inteliclinic/NeuroonOpenHardwareDocumentation/NeuroOn_Assembly.PDF

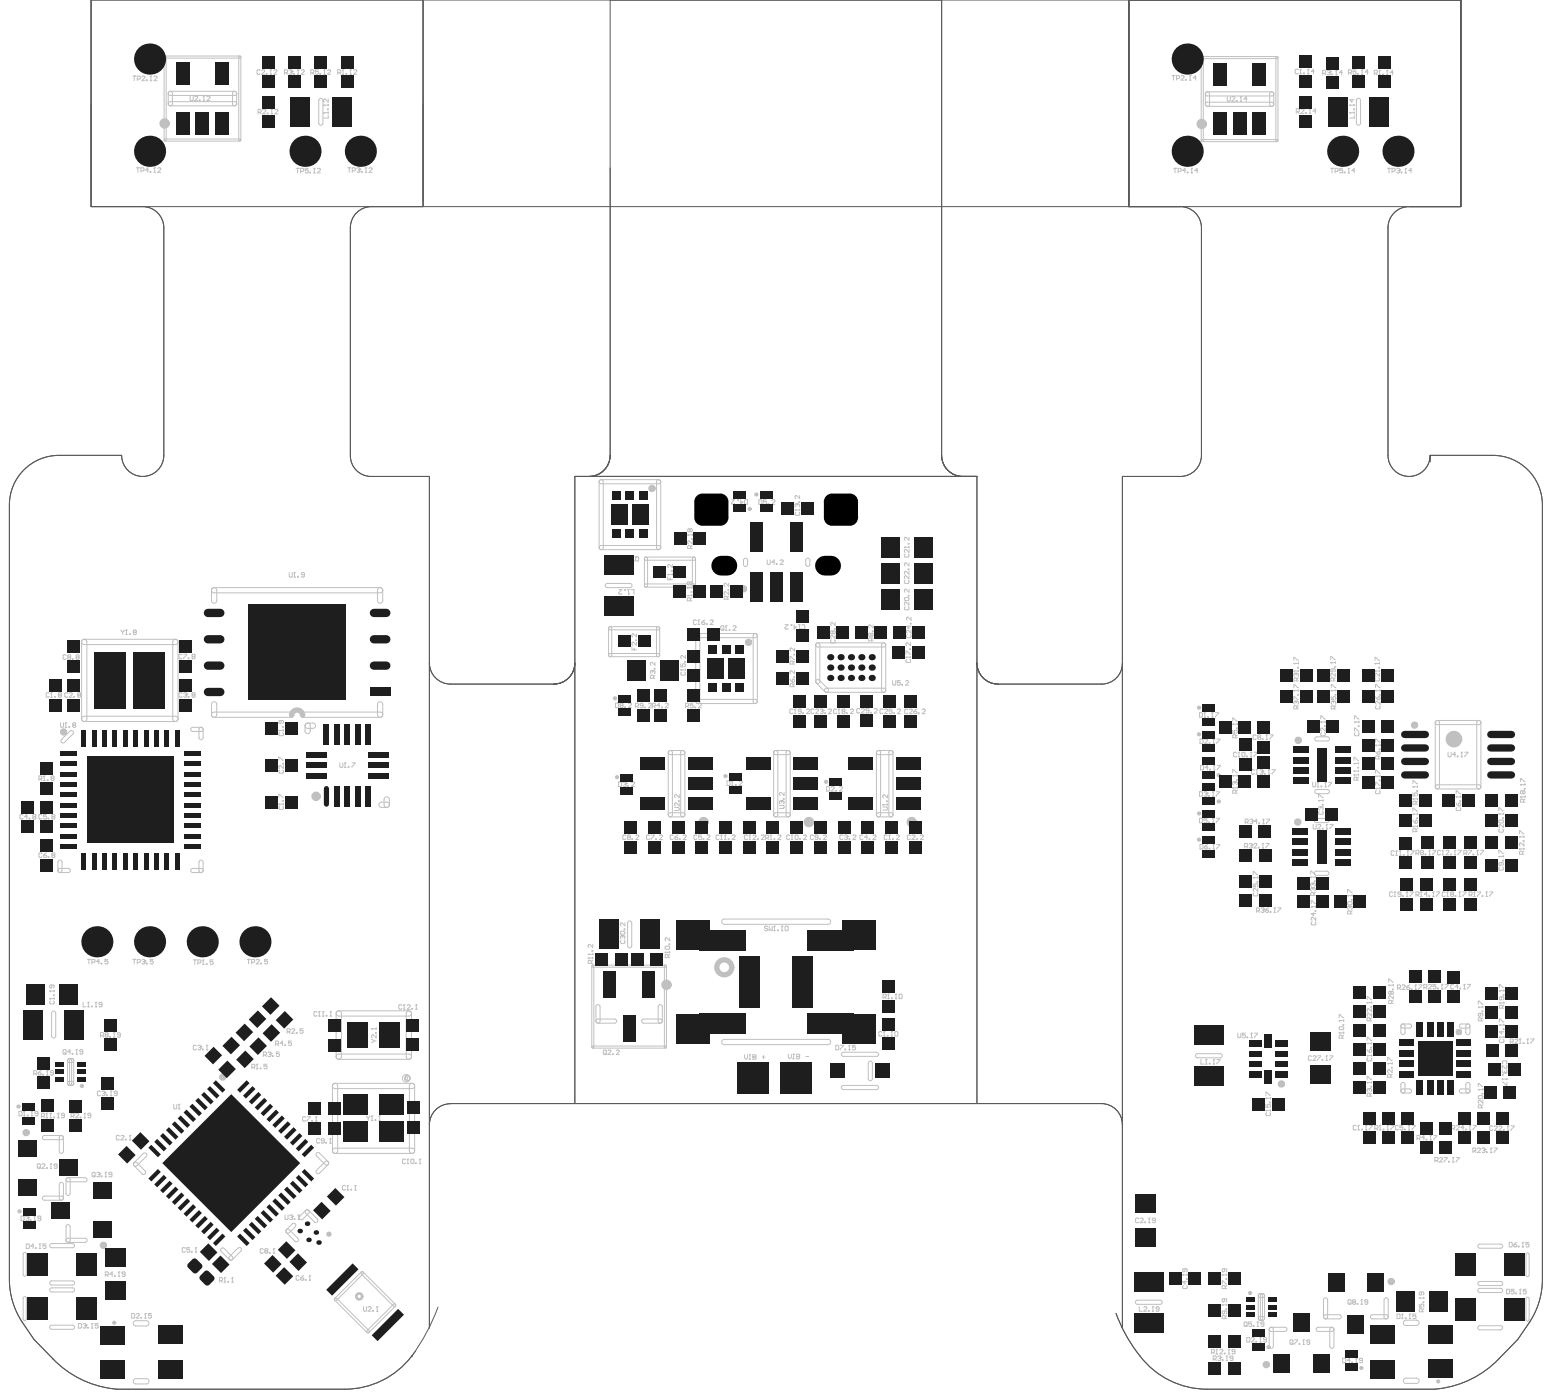
[picture p1: page 1]

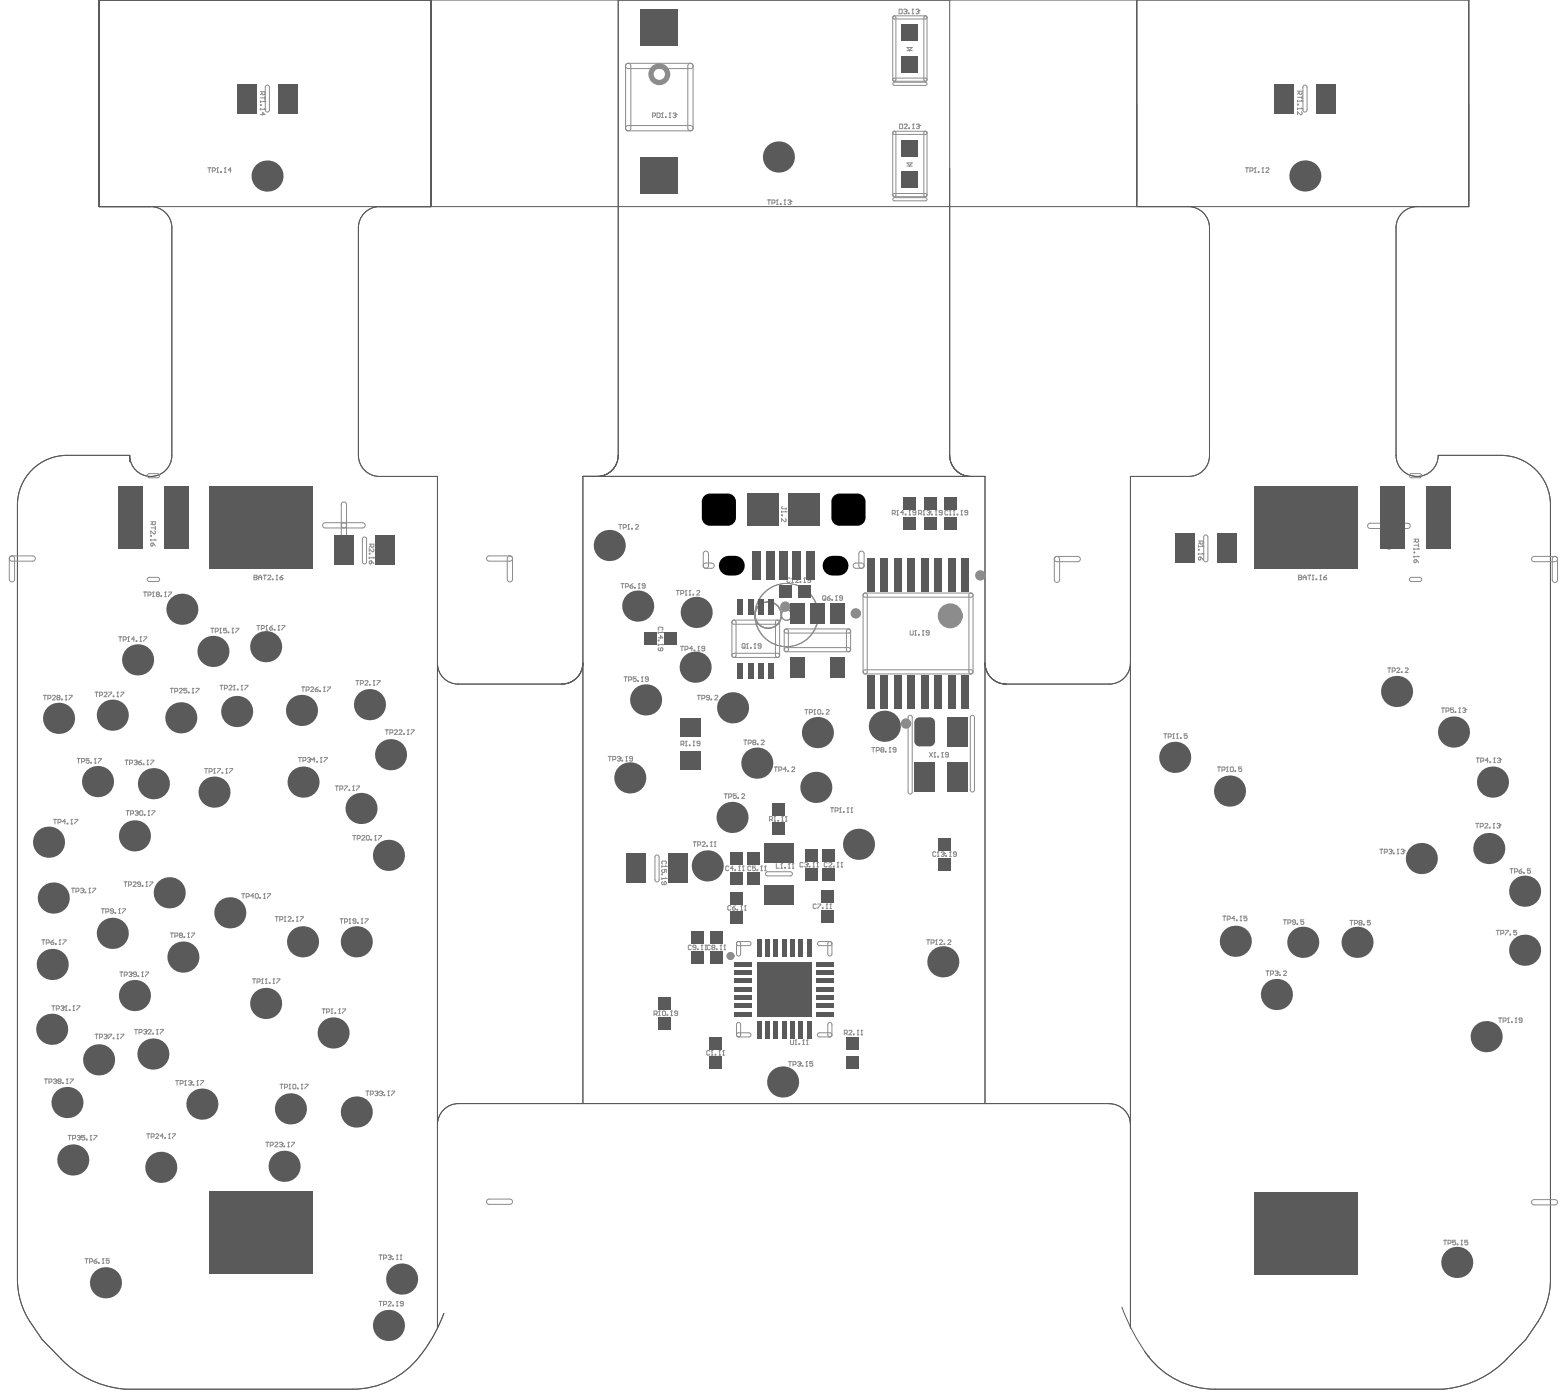
[picture p2: page 2]
