inteliclinic/NeuroonOpenHardwareDocumentation/NeuroOnMainBoard.pdf

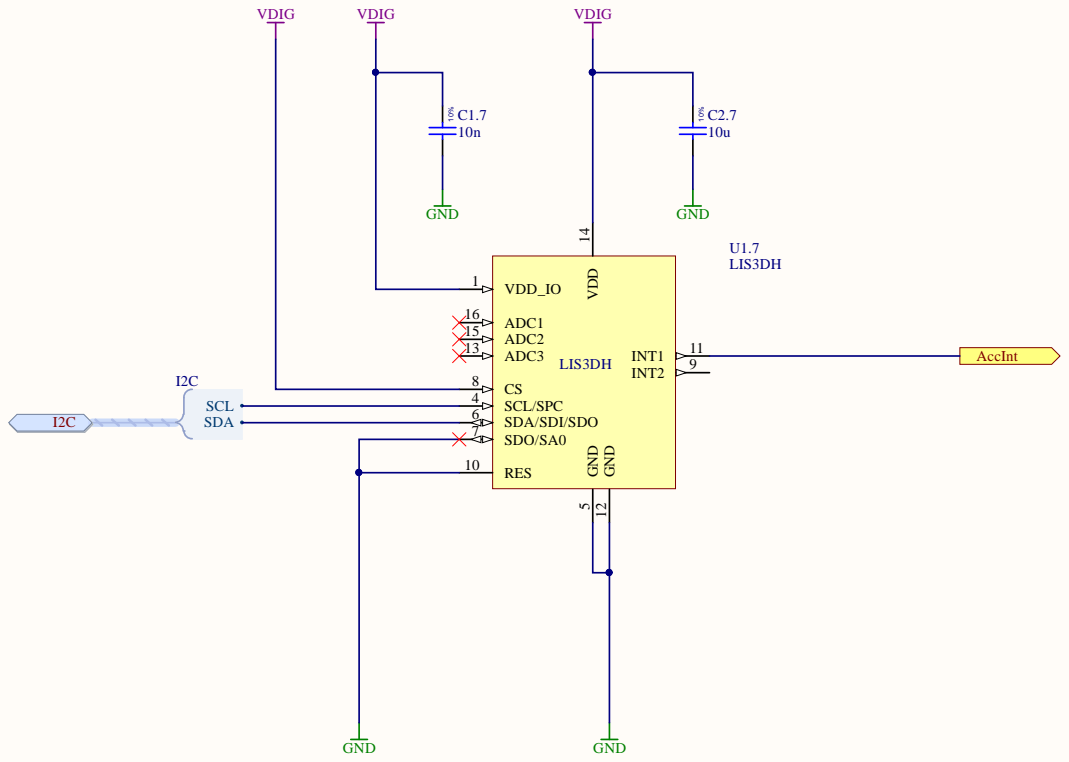
[picture p12: page 1]

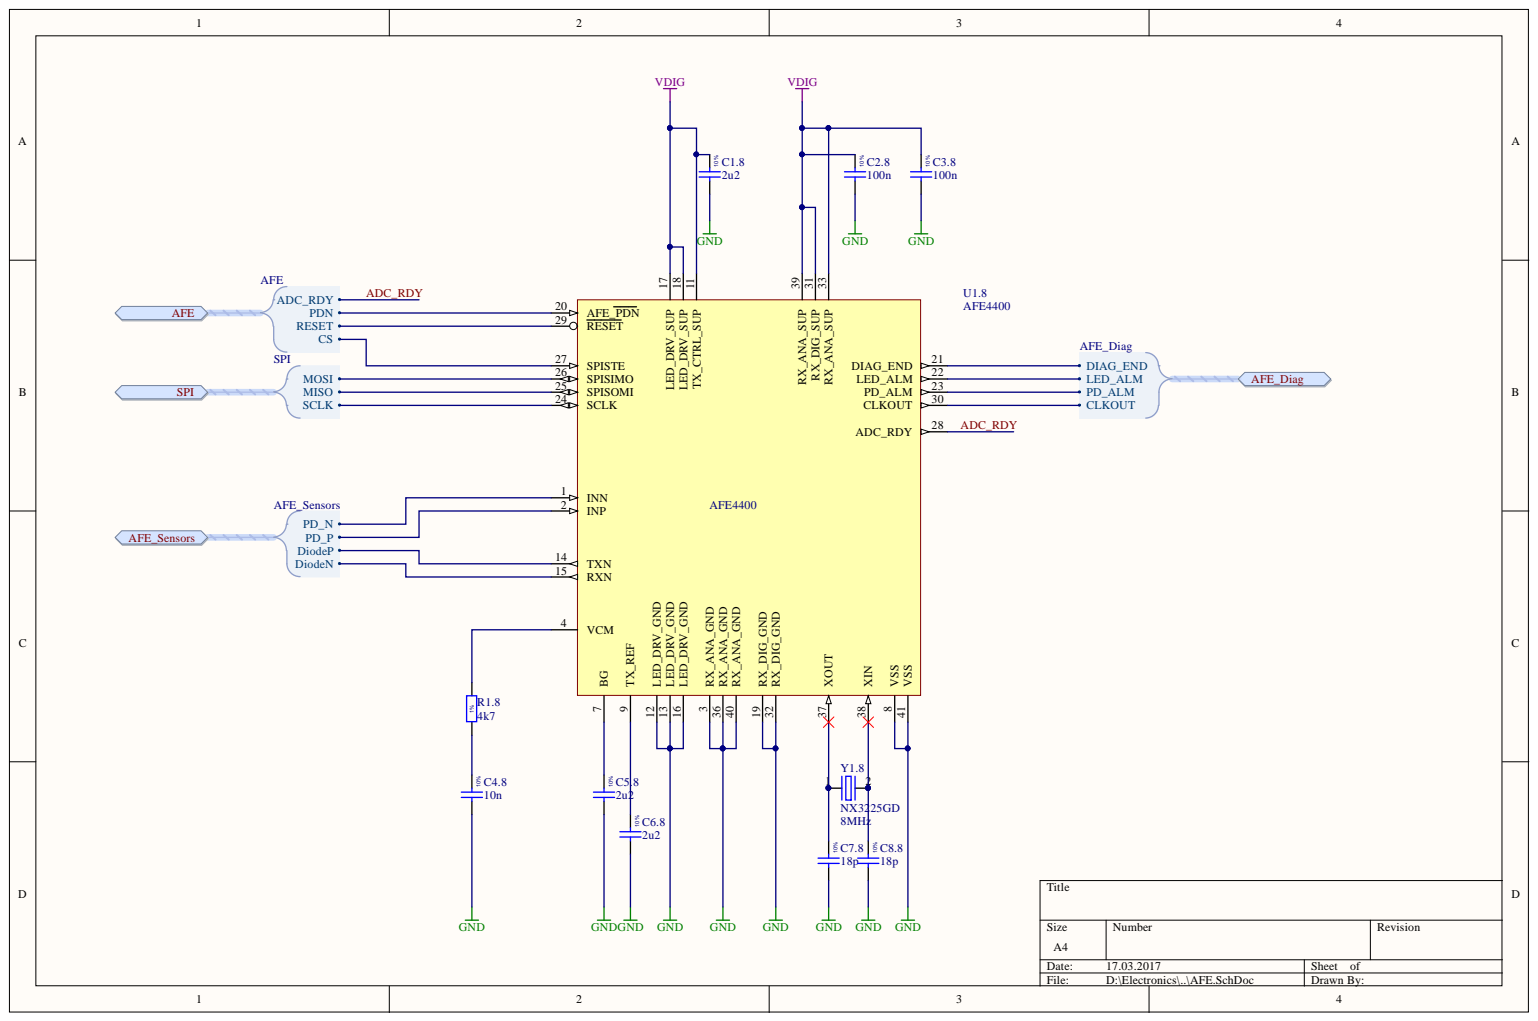
[picture p13: page 2]

VCM 4

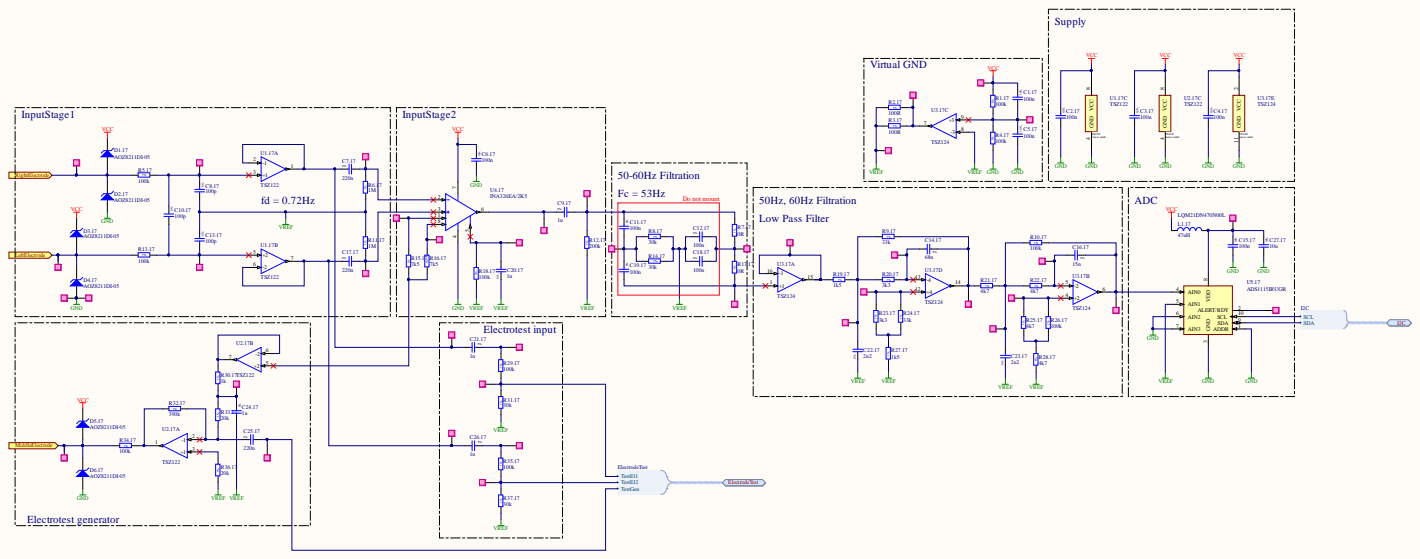
[picture p14: page 3]

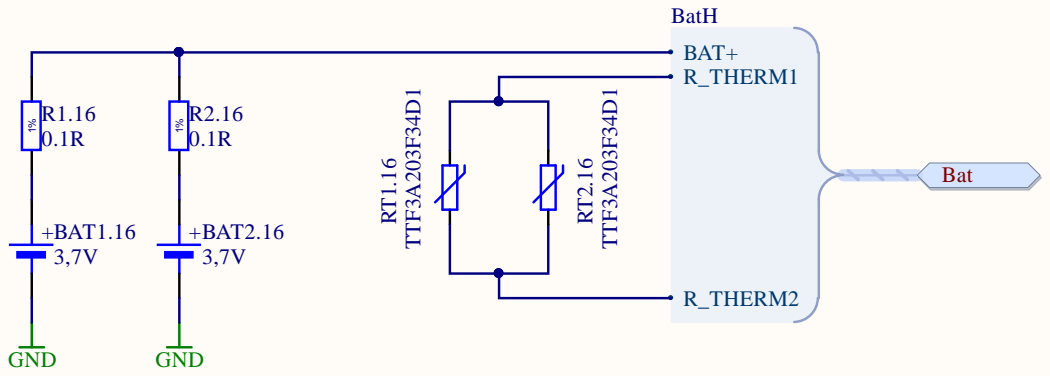
[picture p15: page 4]

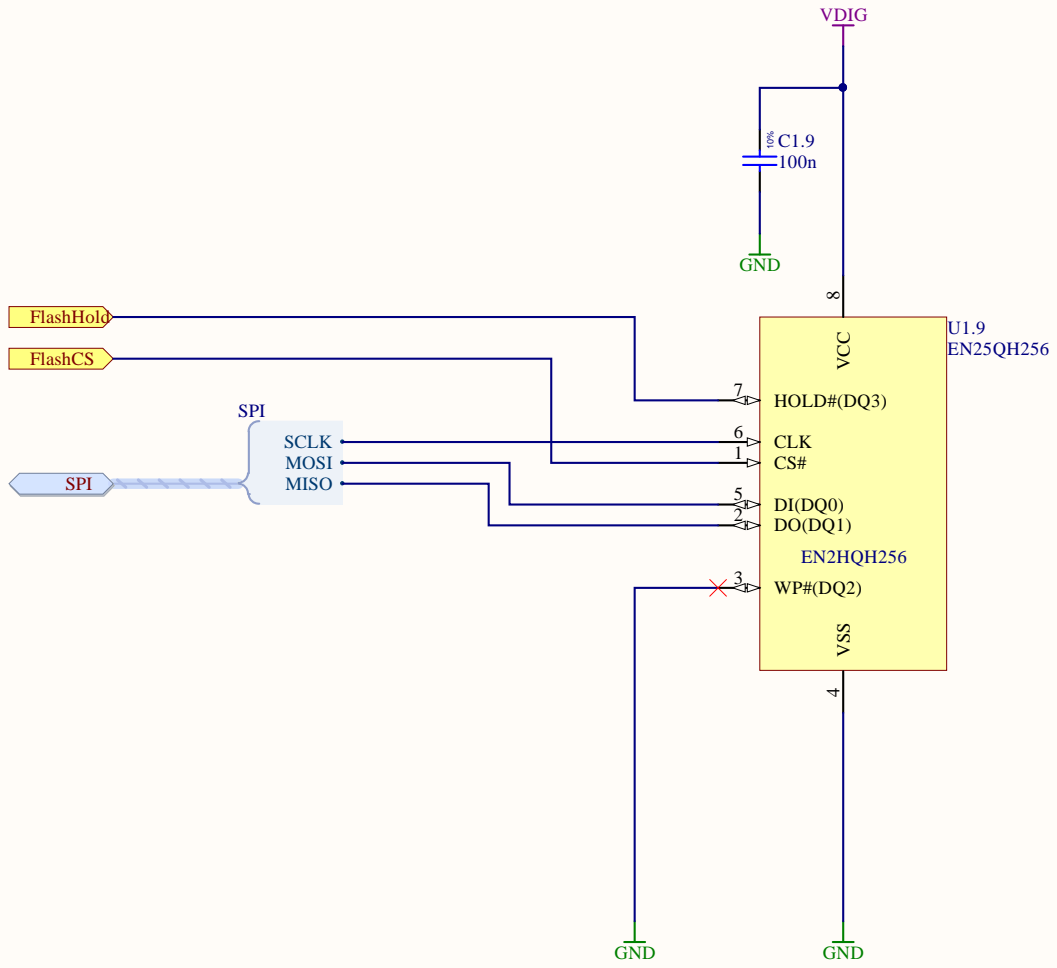
[picture p16: page 5]

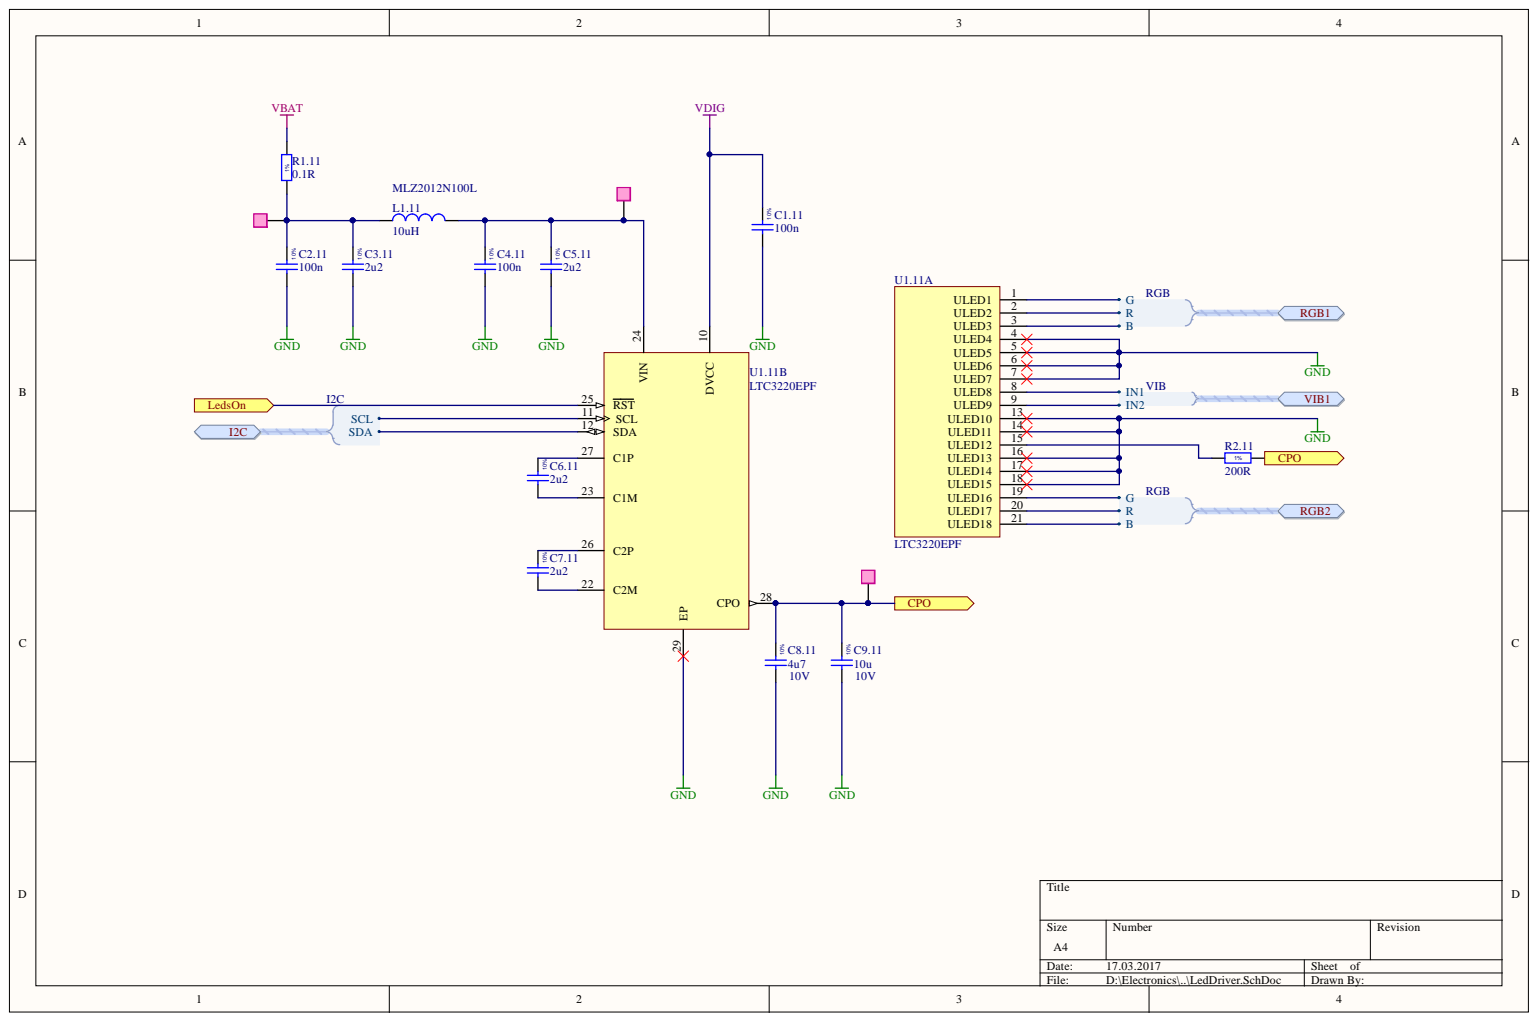
[picture p17: page 6]

1 4
1 5
1 6
1 7 | 1 %

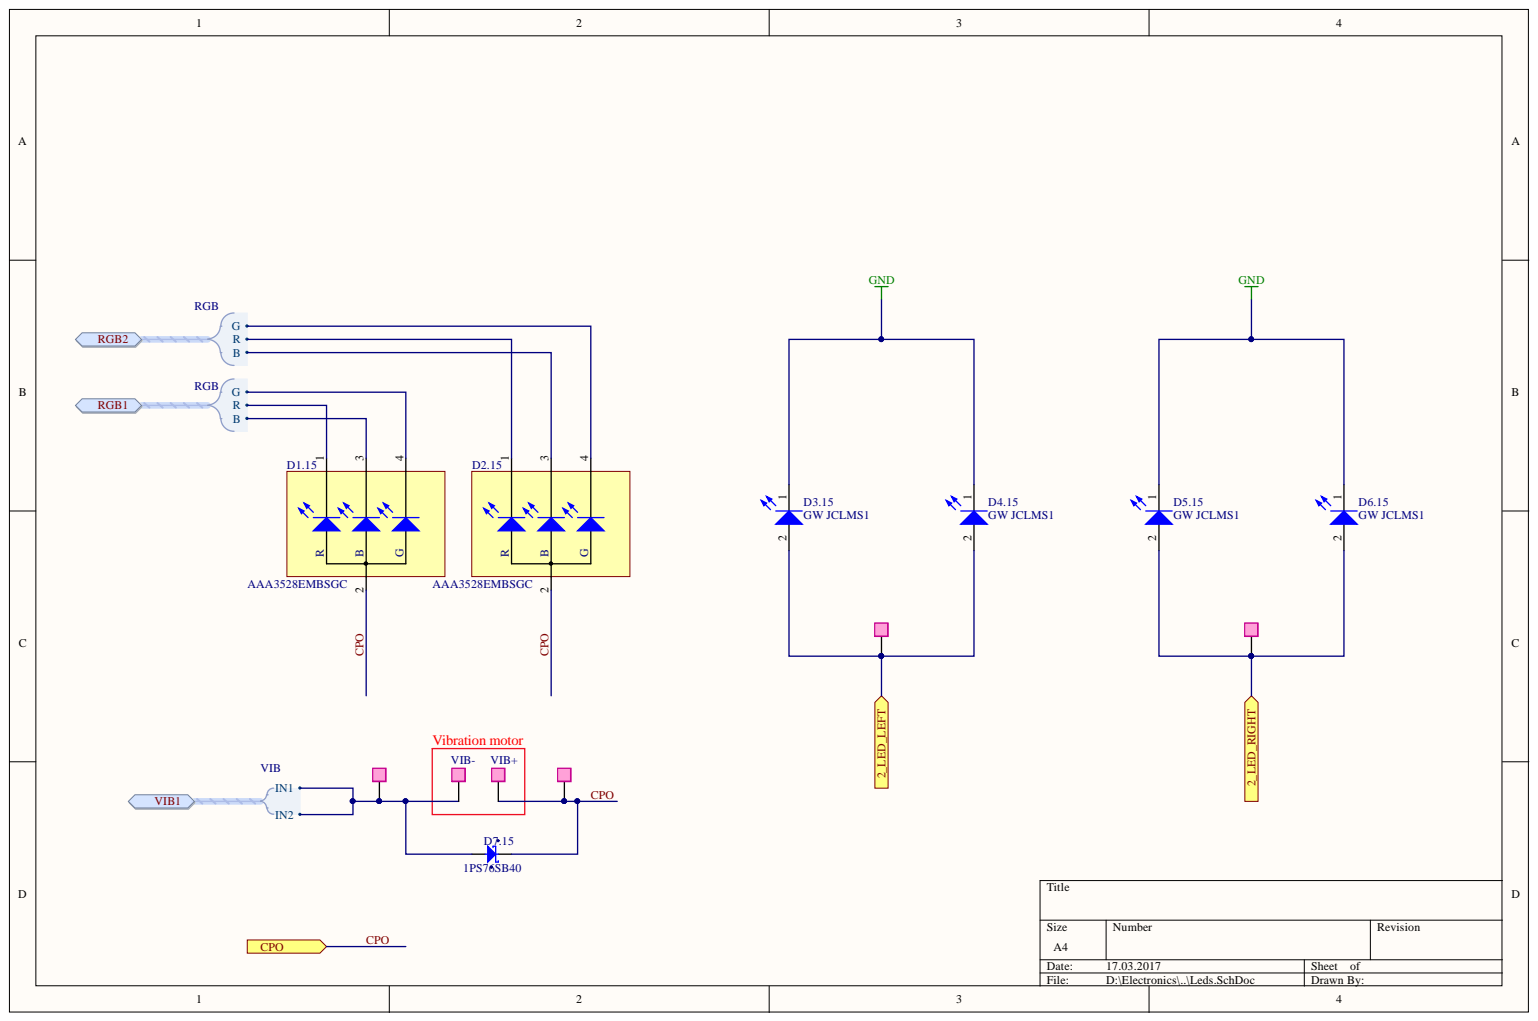
[picture p18: page 7]

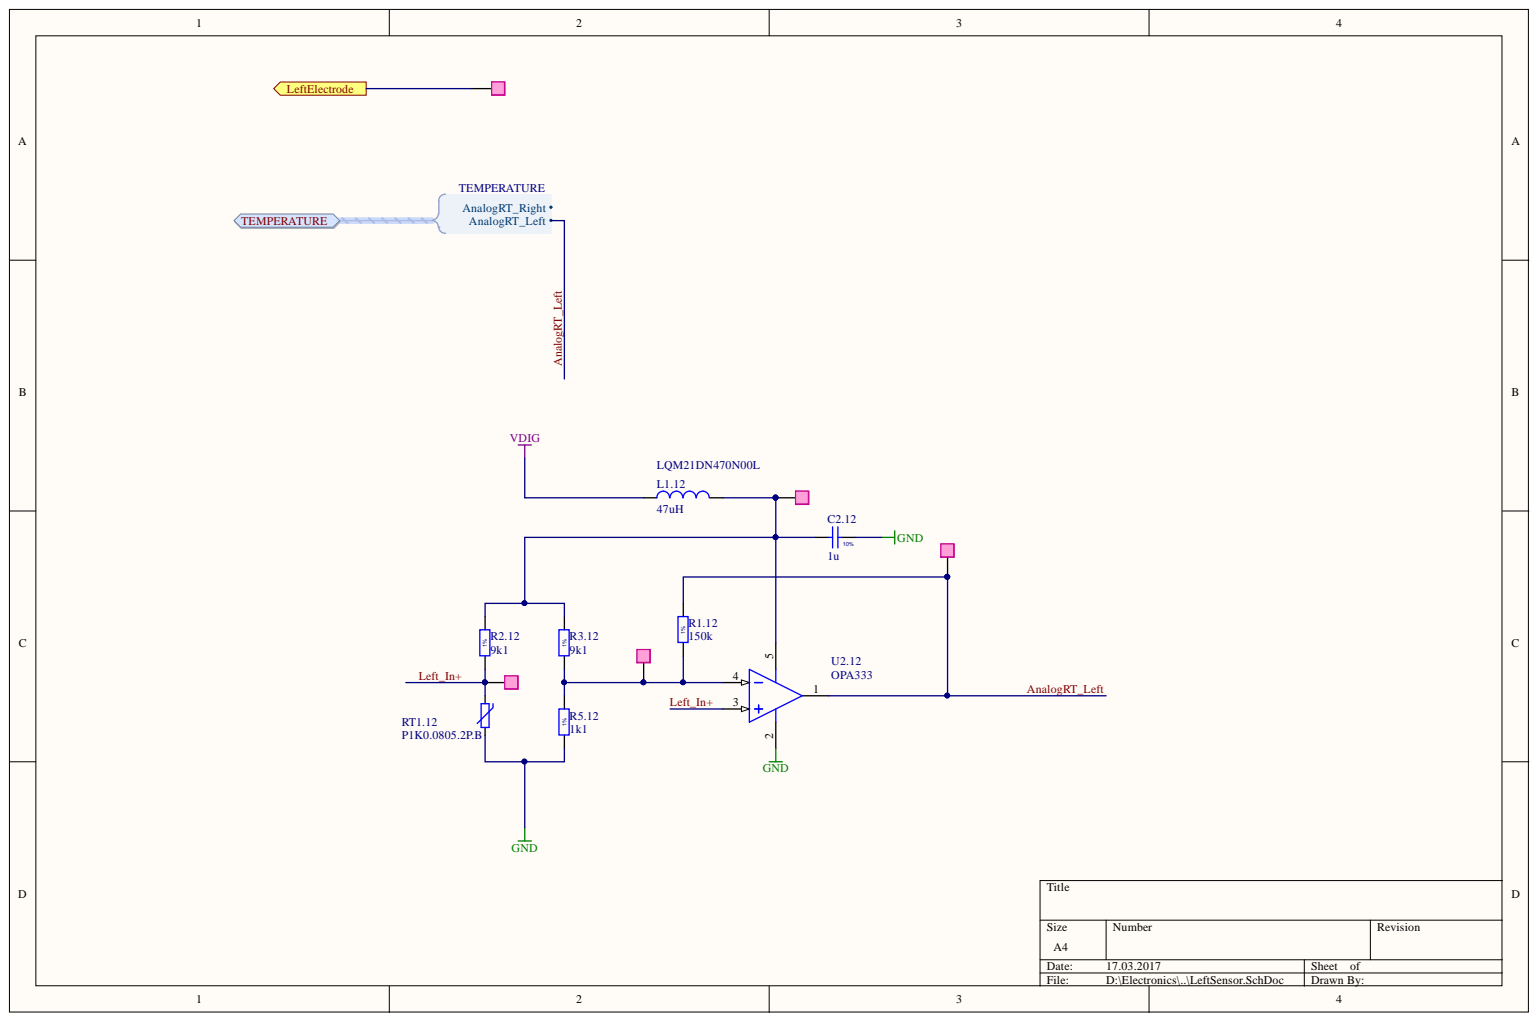
[picture p19: page 8]

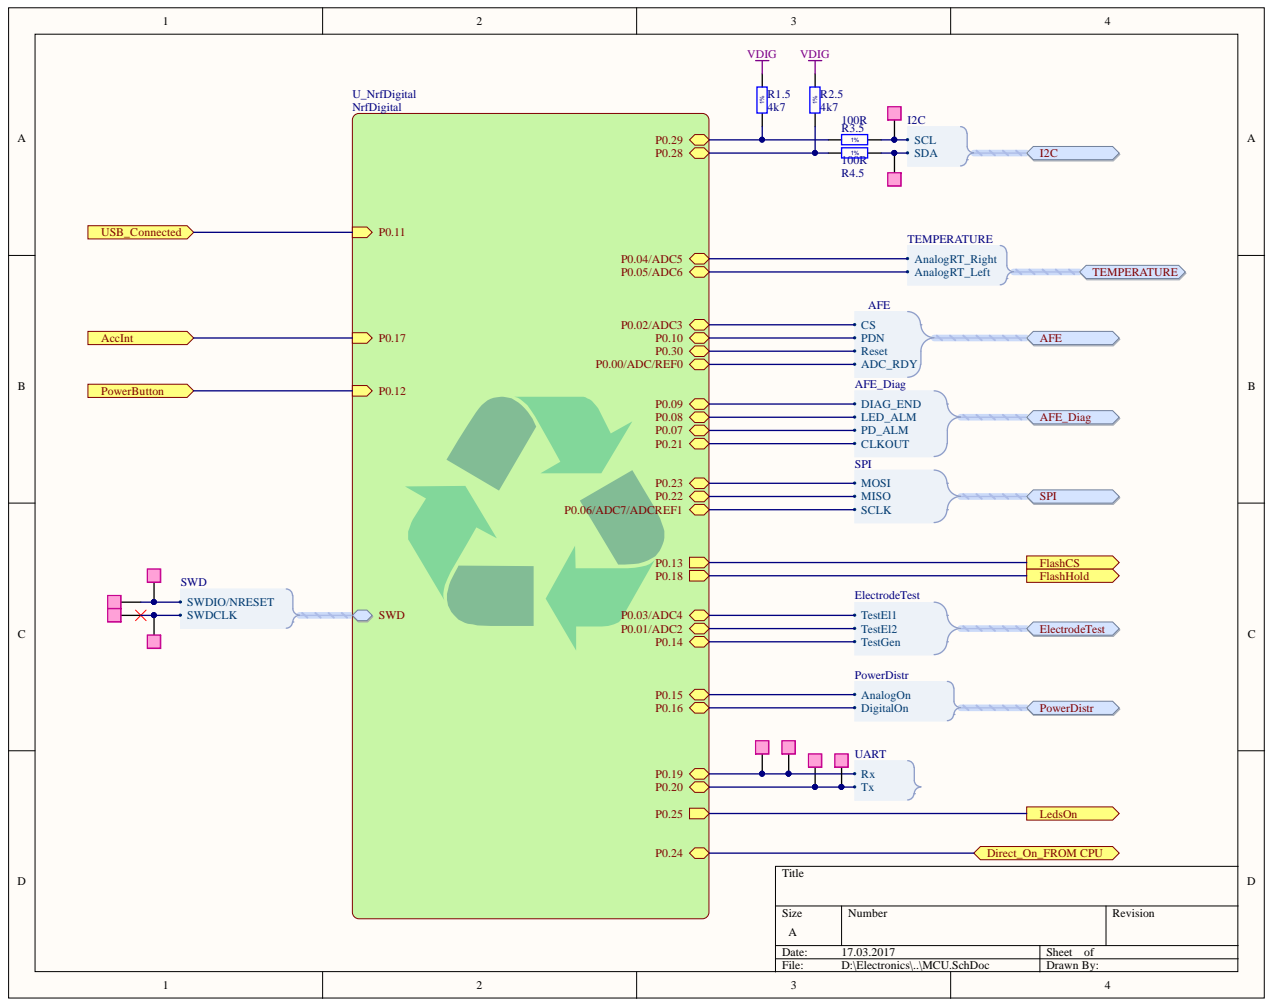
[picture p20: page 9]

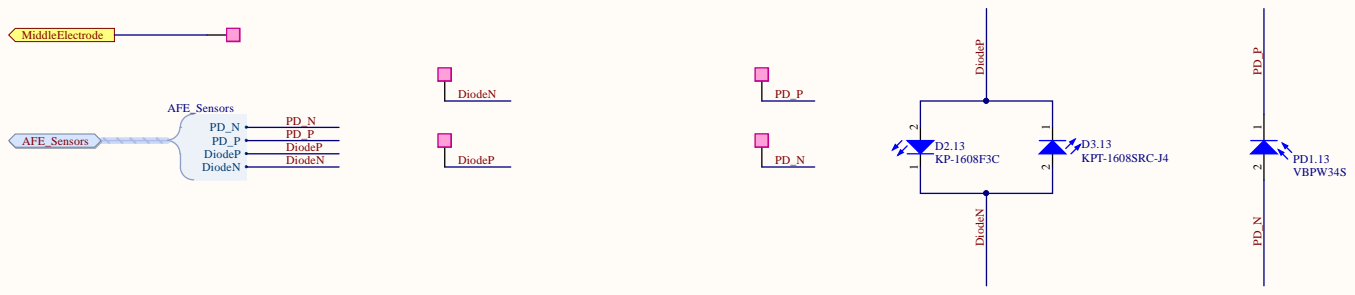
[picture p21: page 10]

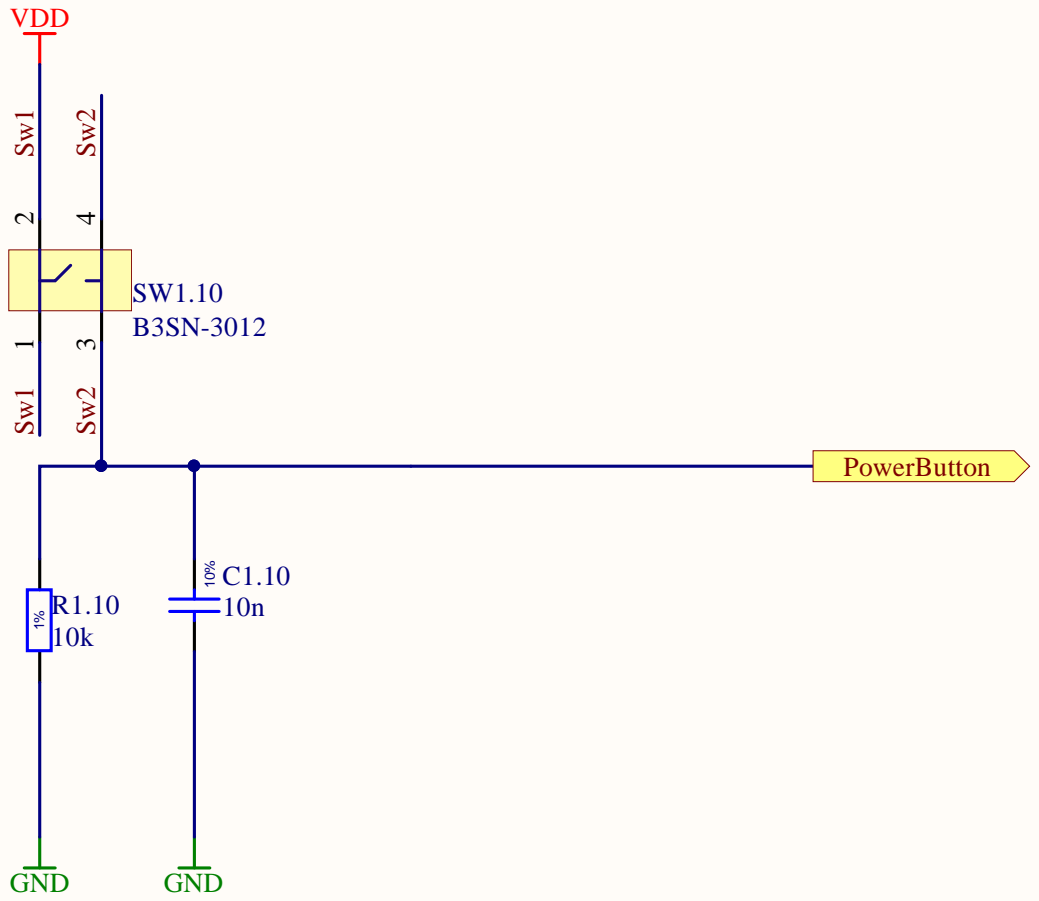
[picture p22: page 11]

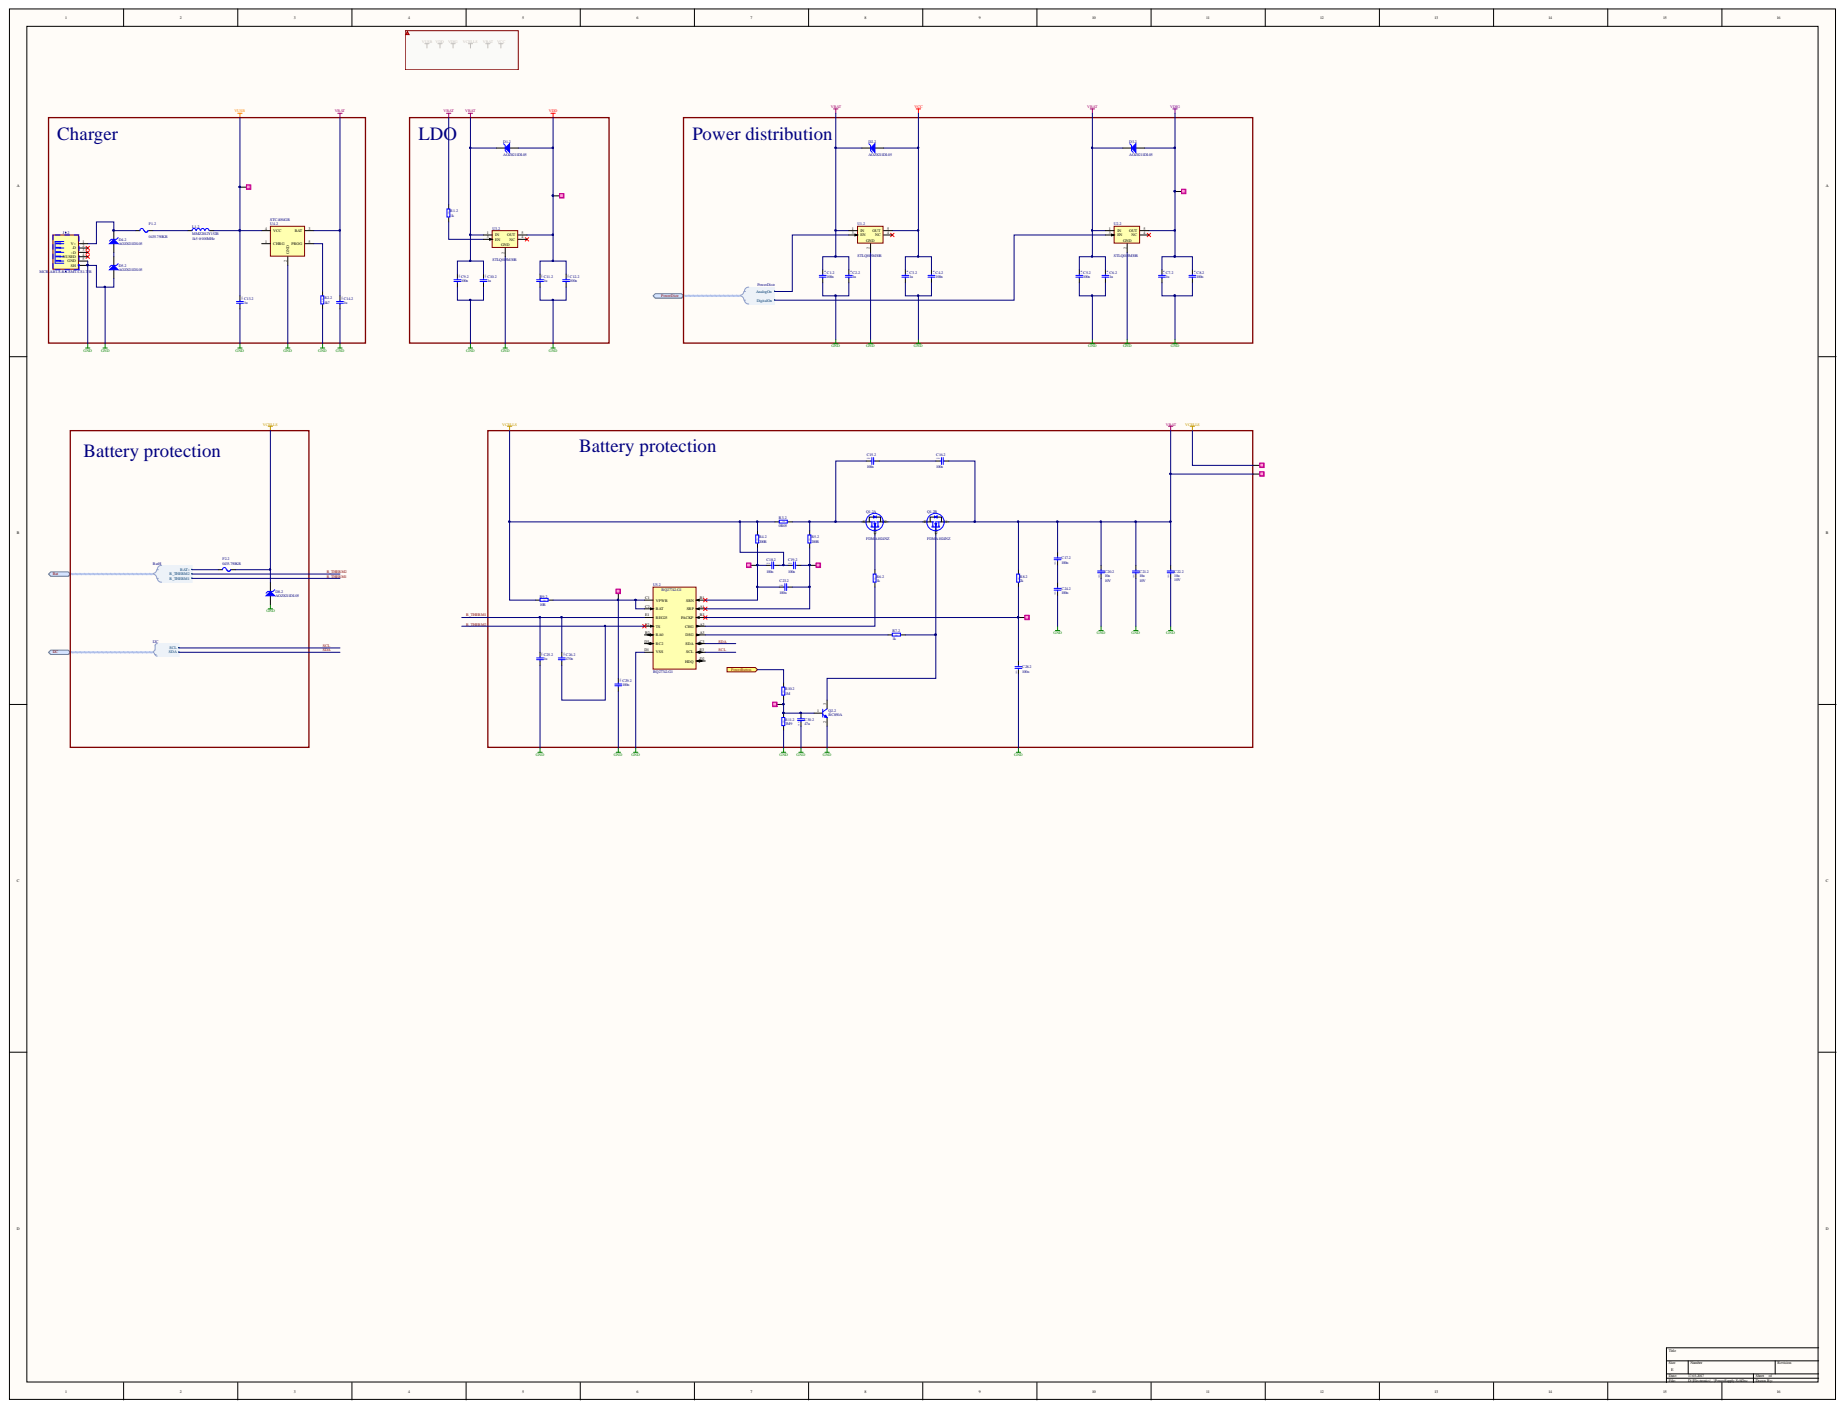
[picture p23: page 12]

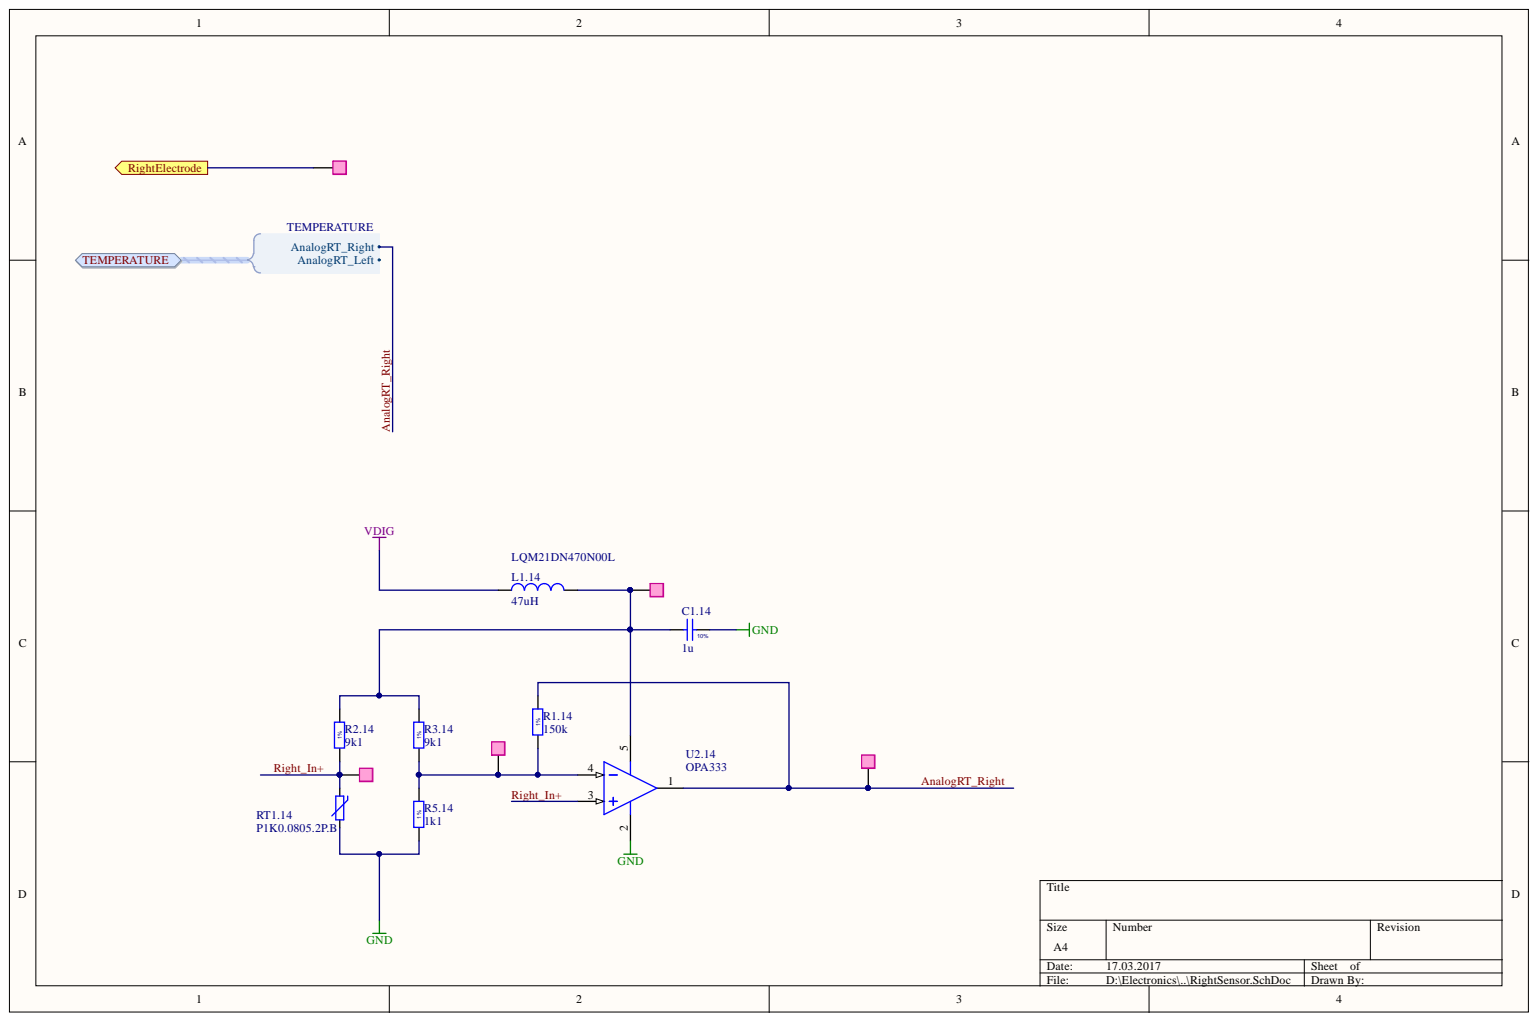
[picture p24: page 13]

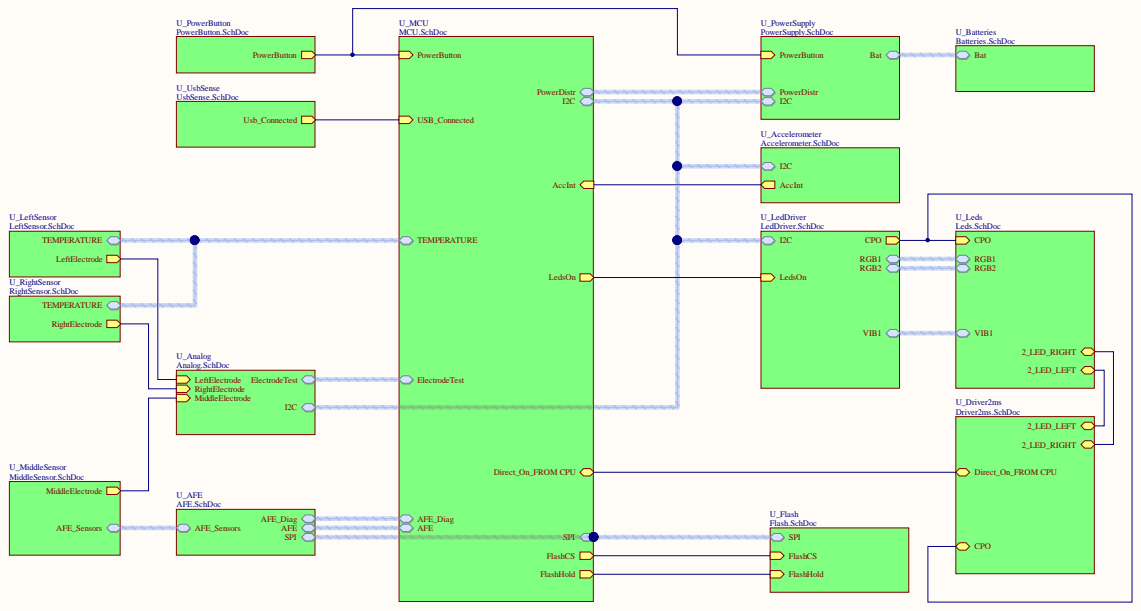
[picture p25: page 14]

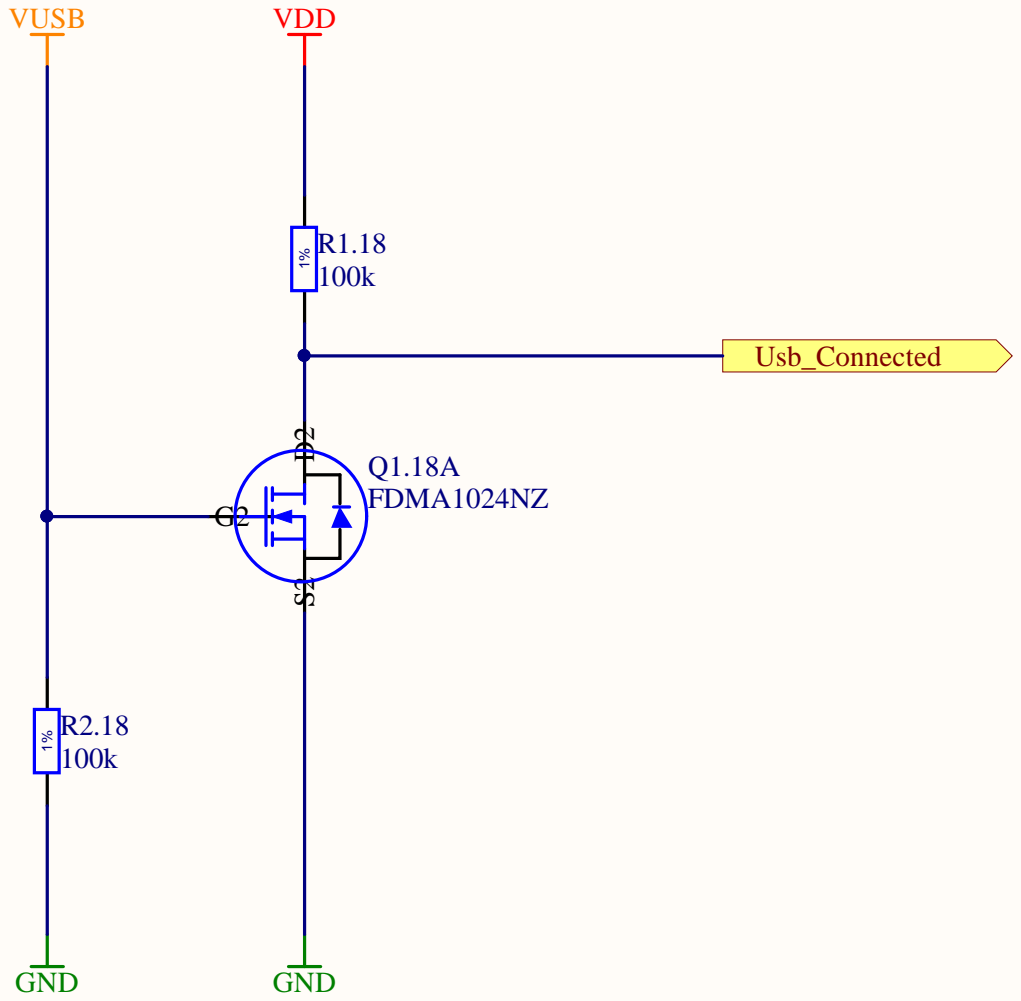
[picture p26: page 15]

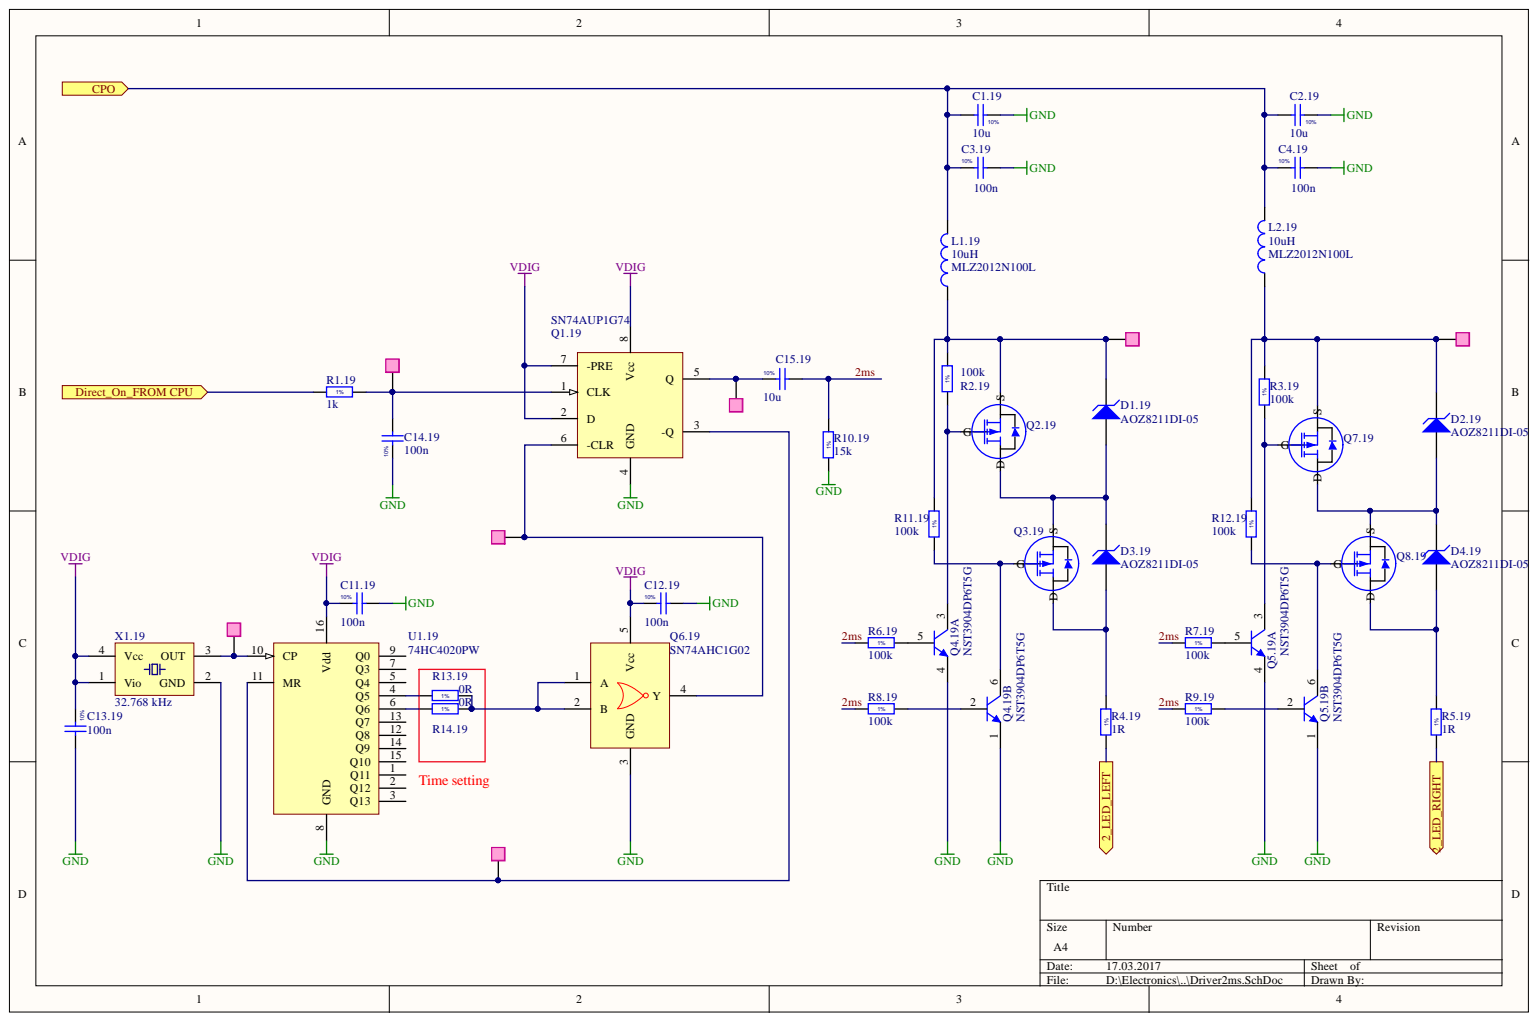
[picture p27: page 16]
