inteliclinic/NeuroonOpenHardwareDocumentation/(commit log)

2017-07-06 Add Layout, 3D_view_unfloded, Assembly
2017-07-06 Add directory gerber
2017-07-11 Add files via upload
    Extended description of Biological Amplifier, power management.
    Layouts, 3D model included.
2017-07-13 BOM file
